patrickyeon/battery-characterizer/hw/instrumentationamp/outputs/instrument-amplifier.pdf

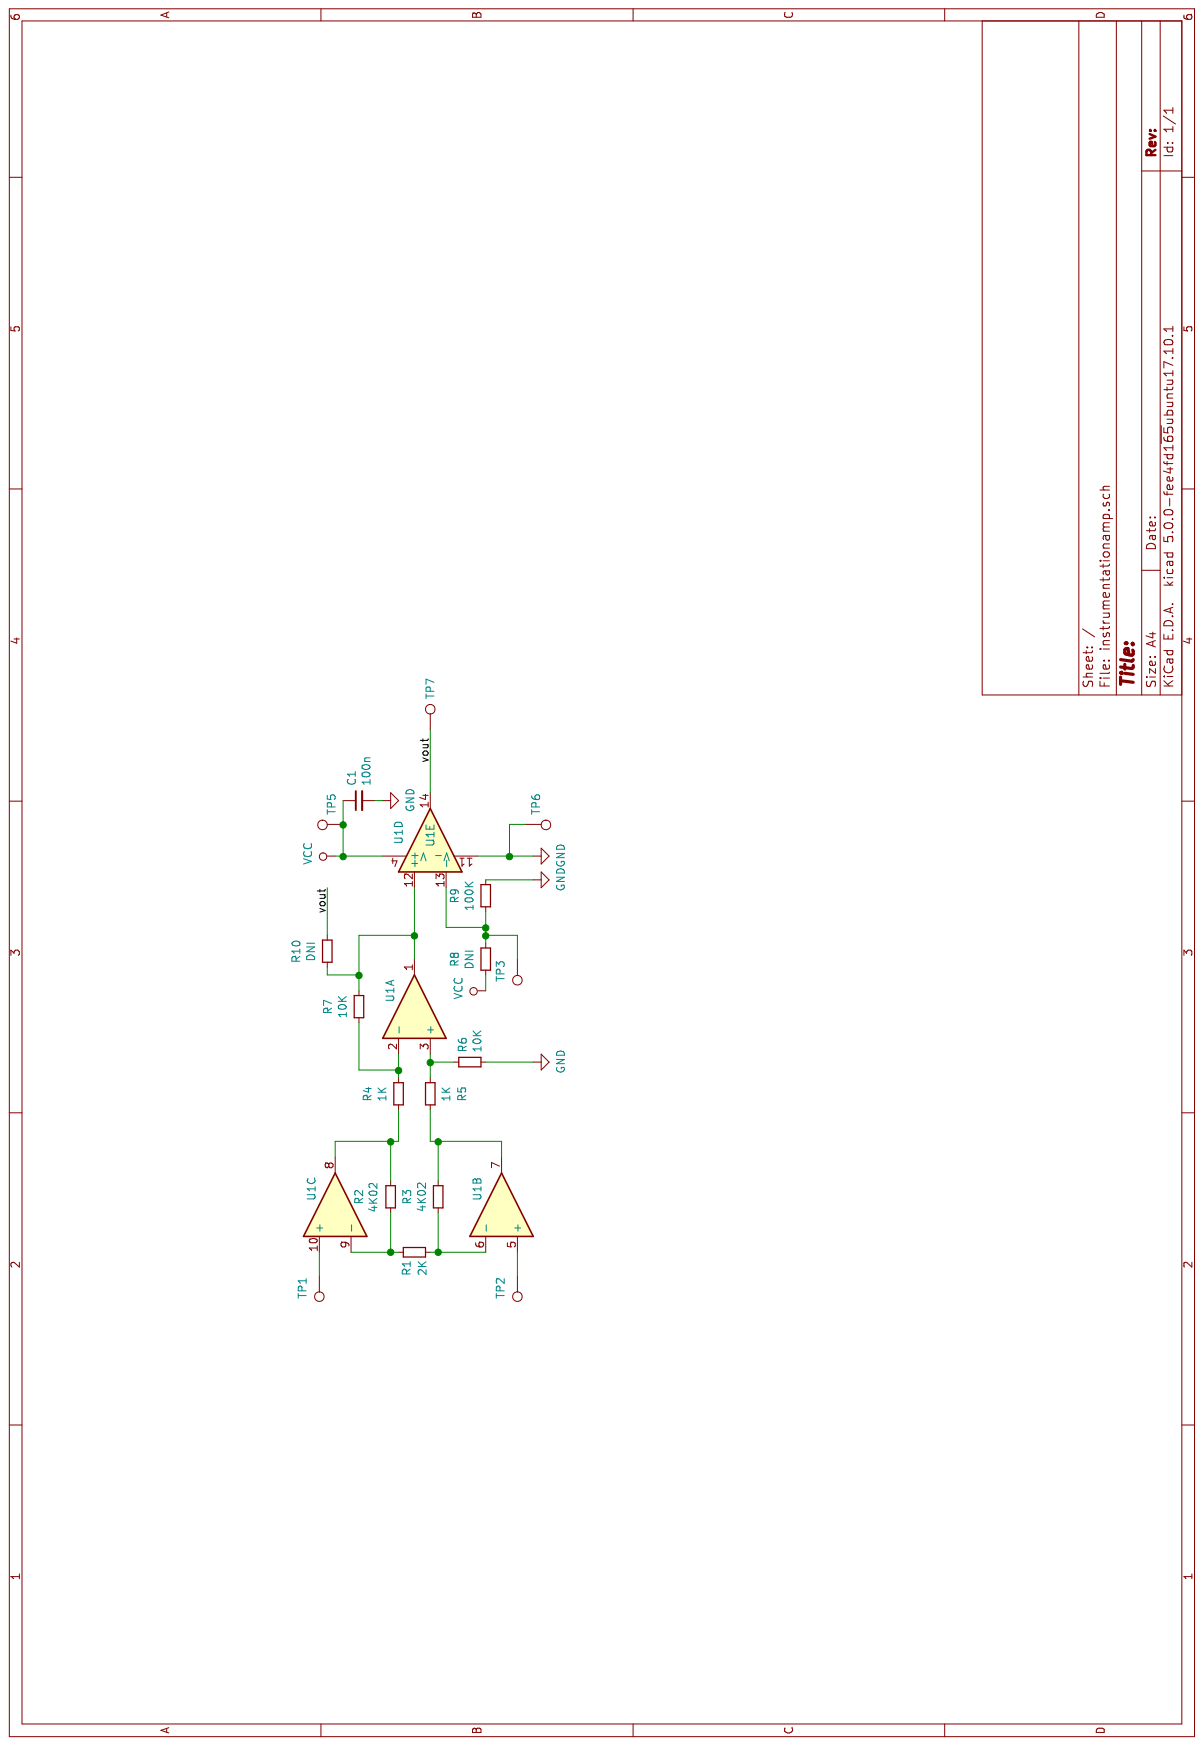
[picture p1: page 1]
