patrickyeon/battery-characterizer/docs/chrg_ilim.asc

C1: cap; 1µ
C2: cap; 100n
C3: cap; 10n
C4: cap; 1n
D1: schottky; MBRB2545CT
E1: e; 1000
M1: nmos; BSS123
M2: pmos; BSS84
R1: res; 4k
R2: res; 100meg
R3: res; 1k
R4: res; 1k
R5: res; 1k
R6: res; 10k
R7: res; 10k
R8: res; 0.01
R9: res; 3.3k
R10: res; 0.15
R11: res; 2k
R12: res; 1k
R13: res; 4k
R14: res; 4k
R15: res; 1k
R16: res; 3.3k
R17: res; 86.6k
R18: res; 14.3k
R19: res; 250k
R20: res; 250k
R21: res; 10k
U1: LTC6244
U2: LTC6244
U3: LTC6244
U4: LTC6244
V1: voltage; PULSE(0 3.3 0 1n 1n 0.001374m 0.01374m)
V2: voltage; 6
V3: voltage; 0.6
V4: voltage; 3.5
Named nets: 0, vpwm, vfilt, vcc, vhi, vctrl, vout, vlo, vsens
.tran 20m
VCC
MCU PWM output
