patrickyeon/battery-characterizer/docs/dchrg_ilim_modding.asc

C1: cap; 1µ
C2: cap; 10n
C3: cap; 10n
M1: nmos; BSS123
M2: nmos; BSS123
M3: nmos; PSMN6R130YLD
M4: nmos; BSS123
R1: res; 4k
R2: res; 100meg
R3: res; 1k
R4: res; 1k
R5: res; 1k
R6: res; 10k
R7: res; 10k
R8: res; 0.01
R9: res; 10k
R10: res; 0.15
R11: res; 2k
R12: res; 1k
R13: res; 4k
R14: res; 4k
R15: res; 10k
R16: res; 10k
R17: res; 10k
R18: res; 0
R19: res; 250k
R20: res; 250k
U1: LTC6244
U2: LTC6244
U3: LTC6244
U4: LTC6244
V1: voltage; PULSE(0 3.3 0 1n 1n 0.001374m 0.01375m)
V2: voltage; 6
V3: voltage; PULSE(3.3 0 15m 0.1u 0.1u 15m 40m)
V4: voltage; 4.5
Named nets: 0, vpwm, vfilt, vcc, vhi, vctrl, vout, vlo, en, vgate
.tran 20m
Enable/Disable logic
VCC
MCU PWM output
