patrickyeon/battery-characterizer/docs/direction_control.asc

D2: schottky; BAT54
D3: schottky; BAT54
D4: schottky; BAT54
D5: schottky; BAT54
I1: current; 0
I2: current; 0
M1: pmos; FDS4465
M2: pmos; FDS4465
M3: nmos; BSS123
M4: pmos; FDS4465
M5: pmos; FDS4465
M6: nmos; BSS123
M7: pmos; FDS4465
M8: pmos; FDS4465
M9: nmos; BSS123
M10: pmos; FDS4465
M11: pmos; FDS4465
M12: nmos; BSS123
R1: res; 3.3k
R2: res; 3.3k
R3: res; 3.3k
R4: res; 3.3k
R5: res; 0.15
R6: res; 3.3k
R7: res; 3.3k
R8: res; 3.3k
R9: res; 3.3k
R10: res; 0.15
R11: res; 0.01
R12: res; 0.01
V1: voltage; 6
V2: voltage; 3.3
V3: voltage; 0
V4: voltage; 3.5
V5: voltage; 3.5
Named nets: batt0, 0, dir, batt1, ndir, vchg, vcc, vdis
Charging section
Discharging
.op
