patrickyeon/battery-characterizer/docs/dchrg_ilim.asc

C1: cap; 1µ
C2: cap; 1µ
I1: current; SINE(0.4 0.4 20)
M1: nmos
R1: res; 4k
R2: res; 100k
R3: res; 2k
R4: res; 2k
R5: res; 1k
R6: res; 100k
R7: res; 100k
R8: res; 0.01
R9: res; 100k
R10: res; 2
R11: res; 100
R12: res; 200k
U1: LTC6244
U2: LTC6244
V1: voltage; PULSE(0 3.3 0 1n 1n 0.001374m 0.01375m)
V2: voltage; 6
V3: voltage; SINE(0.003 0.003 20)
Named nets: 0, vpwm, vfilt, vcc, vhi, vctrl, vout, vlo
.tran 80m
