patrickyeon/battery-characterizer/hw/instrumentationamp/instrumentationamp.kicad_pcb

## KiCad design hw/instrumentationamp/instrumentationamp.kicad_pcb (2018-10-24)

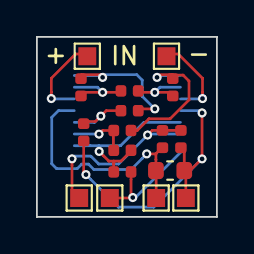
[picture p2: board instrumentationamp.kicad_pcb from above]

Board: 2 copper layers, 10.0 x 10.0 mm, 18 parts (1 on the bottom side), 13 nets.

Parts:
C1: 100n; C_0603_1608Metric
R1: 2K; R_0402_1005Metric
R2, R3: 4K02; R_0402_1005Metric
R4, R5: 1K; R_0402_1005Metric
R6, R7: 10K; R_0402_1005Metric
R8, R10: DNI; R_0402_1005Metric
R9: 100K; R_0402_1005Metric
TP1, TP2, TP3, TP5, TP6, TP7: Test_Point; TestPoint_Pad_1.0x1.0mm
U1: Opamp_Quad_Generic; TSSOP-14_4.4x5mm_P0.65mm

Connections:
/vout: R10.1, TP7.1, U1.14
GND: C1.2, R6.2, R9.1, TP6.1, U1.11
unnamed: R1.1, R2.1, U1.9
unnamed: R1.2, R3.2, U1.6
unnamed: R2.2, R4.2, U1.8
unnamed: R3.1, R5.2, U1.7
unnamed: R4.1, R7.2, U1.2
unnamed: R5.1, R6.1, U1.3
unnamed: R8.1, R9.2, TP3.1, U1.13
unnamed: R7.1, R10.2, U1.1, U1.12
unnamed: TP1.1, U1.10
unnamed: TP2.1, U1.5
VCC: C1.1, R8.2, TP5.1, U1.4
