patrickyeon/battery-characterizer/hw/characterizer/characterizer.kicad_pcb

## KiCad design hw/characterizer/characterizer.kicad_pcb (2018-10-16)

Schematic: characterizer.sch

Parts:
C1: 1u; C_0603_1608Metric
C2: 470p; C_0603_1608Metric
C3: 2u2; C_0603_1608Metric
J1: 1988820; TERM_4_5mm; Digikey PN 277-1766-ND
R1: 0R; R_0603_1608Metric
R2: DNI; R_0603_1608Metric
R3, R4, R5: 10k; R_0603_1608Metric
U1: MIC5205-3.3; SOT-23-5; Digikey PN 576-1259-1-ND

Connections:
+3V3: C3.1, R5.1, U1.5 (OUT); also elsewhere on the board
+5V: R2.1; also elsewhere on the board
+6V: J1.1, J1.2, R1.1; also elsewhere on the board
/pairA/ADDR: R4.1; also elsewhere on the board
/pairB/ADDR: R5.2; also elsewhere on the board
GND: C1.2, C2.2, C3.2, J1.3, J1.4, R4.2, U1.2 (GND); also elsewhere on the board
unnamed: C1.1, R1.2, R2.2, R3.1, U1.1 (IN)
unnamed: C2.1, U1.4 (BP)
unnamed: R3.2, U1.3 (EN)

Schematic: control.sch

Parts:
C4: 4n7; C_0603_1608Metric
C5, C7, C9, C10, C11, C12, C13, C14: 100n; C_0603_1608Metric
C6, C8: 18p; C_0603_1608Metric
J2: Conn_02x05_Odd_Even; CONN_JTAG_10; Digikey PN 1175-1629-ND
J3: 10118194-0001LF; USB-microB-AMPH; Digikey PN 609-4618-1-ND
R6: 1M; R_0603_1608Metric
R7: DNI; R_0603_1608Metric
R8, R13, R14, R15, R16, R19, R20, R21, R22: 10k; R_0603_1608Metric
R9: 100k; R_0603_1608Metric
R10: 0; R_0603_1608Metric
R11, R12: 3k3; R_0603_1608Metric
R17, R18, R23, R24: 4k02; R_0603_1608Metric
U2: STM32F042K6T6; LQFP-32_7x7mm_P0.8mm; Digikey PN 497-14647-ND
U3: 74LVC2G04GW,125; SOT-363_SC-70-6; Digikey PN 1727-4032-1-ND
Y1: ABLS-8.000MHZ-B4-T; Crystal_SMD_HC49-SD; Digikey PN 535-10212-1-ND

Connections:
+3V3: C5.1, C7.1, C9.1, C10.1, J2.1, R7.1, R11.2, R12.2, U2.1, U2.5, U2.17, U3.5; also elsewhere on the board
+5V: R10.1; also elsewhere on the board
/SCL: R12.1, U2.19; also elsewhere on the board
/SDA: R11.1, U2.20; also elsewhere on the board
/mcu/CC_A: U2.6; also elsewhere on the board
/mcu/CC_B: U2.7; also elsewhere on the board
/mcu/CEN_A: U2.29; also elsewhere on the board
/mcu/CEN_B: U2.25; also elsewhere on the board
/mcu/DC_A: U2.8; also elsewhere on the board
/mcu/DC_B: U2.9; also elsewhere on the board
/mcu/ICHG_A: C14.1, R24.1; also elsewhere on the board
/mcu/ICHG_B: C12.1, R18.1; also elsewhere on the board
/mcu/IDCHG_A: C13.1, R23.1; also elsewhere on the board
/mcu/IDCHG_B: C11.1, R17.1; also elsewhere on the board
/mcu/VBAT0: R15.1; also elsewhere on the board
/mcu/VBAT1: R21.1; also elsewhere on the board
/mcu/VBAT2: R16.1; also elsewhere on the board
/mcu/VBAT3: R22.1; also elsewhere on the board
/pairA/DCHARGE: U2.30; also elsewhere on the board
/pairA/DIR: U2.18, U3.3; also elsewhere on the board
/pairA/nDIR: U3.4; also elsewhere on the board
/pairB/DCHARGE: R7.2, R8.1, U2.31; also elsewhere on the board
/pairB/DIR: U2.26, U3.1; also elsewhere on the board
/pairB/nDIR: U3.6; also elsewhere on the board
GND: C4.2, C5.2, C6.2, C7.2, C8.2, C9.2, C10.2, C11.2, C12.2, C13.2, C14.2, J2.3, J2.5, J2.9, J3.5, R6.1, R8.2, R9.1, R13.2, R14.2, R19.2, R20.2, U2.16, U2.32, U3.2; also elsewhere on the board
unnamed: C4.1, J3.6, J3.7, J3.8, J3.9, R6.2
unnamed: C6.1, U2.2, Y1.1
unnamed: C8.1, U2.3, Y1.2
unnamed: J2.2, U2.23
unnamed: J2.4, U2.24
unnamed: J2.10, U2.4
unnamed: J3.1, R10.2
unnamed: J3.2, U2.21
unnamed: J3.3, U2.22
unnamed: J3.4, R9.2
unnamed: R13.1, R15.2, U2.11
unnamed: R14.1, R16.2, U2.13
unnamed: R17.2, U2.15
unnamed: R18.2, U2.28
unnamed: R19.1, R21.2, U2.10
unnamed: R20.1, R22.2, U2.12
unnamed: R23.2, U2.14
unnamed: R24.2, U2.27

Schematic: pair.sch

Parts:
BT1, BT2: Battery_Cell; 18650-keyelco
C15, C16: 100n; C_0603_1608Metric
F1, F2: MF-USML700-2; R_1210_3225Metric; Digikey PN MF-USML700-2CT-ND
J4, J5, J6, J7: 36-54-ND; BATTERY_CLIP_36-54; Digikey PN 36-54-ND
R25, R26, R27, R28: 10k; R_0603_1608Metric
U4, U5: AT30TS74; MSOP-8_3x3mm_P0.65mm; Digikey PN 1611-AT30TS74-XM8M-B-ND

Connections:
+3V3: C15.1, C16.1, R26.1, U4.8, U5.8; also elsewhere on the board
/SCL: U4.2, U5.2; also elsewhere on the board
/SDA: U4.1, U5.1; also elsewhere on the board
/mcu/VBAT2: J4.1, J4.2, J4.3; also elsewhere on the board
/mcu/VBAT3: J6.1, J6.2, J6.3; also elsewhere on the board
/pairB/ADDR: U4.5, U5.5; also elsewhere on the board
GND: C15.2, C16.2, F1.2, F2.2, R25.2, R27.2, R28.2, U4.4, U5.4; also elsewhere on the board
unnamed: F1.1, J5.1, J5.2, J5.3
unnamed: F2.1, J7.1, J7.2, J7.3
unnamed: R25.1, U4.7
unnamed: R26.2, U5.7
unnamed: R27.1, U4.6
unnamed: R28.1, U5.6

Parts of its further copies:
BT3, BT4: Battery_Cell; 18650-keyelco
C32, C33: 100n; C_0603_1608Metric
F3, F4: MF-USML700-2; R_1210_3225Metric; Digikey PN MF-USML700-2CT-ND
J8, J9, J10, J11: 36-54-ND; BATTERY_CLIP_36-54; Digikey PN 36-54-ND
R62, R63, R64, R65: 10k; R_0603_1608Metric
U9, U10: AT30TS74; MSOP-8_3x3mm_P0.65mm; Digikey PN 1611-AT30TS74-XM8M-B-ND

Connections of its further copies:
+3V3: C32.1, C33.1, R63.1, U9.8, U10.8; also elsewhere on the board
/SCL: U9.2, U10.2; also elsewhere on the board
/SDA: U9.1, U10.1; also elsewhere on the board
/mcu/VBAT0: J8.1, J8.2, J8.3; also elsewhere on the board
/mcu/VBAT1: J10.1, J10.2, J10.3; also elsewhere on the board
/pairA/ADDR: U9.5, U10.5; also elsewhere on the board
GND: C32.2, C33.2, F3.2, F4.2, R62.2, R64.2, R65.2, U9.4, U10.4; also elsewhere on the board
unnamed: F3.1, J9.1, J9.2, J9.3
unnamed: F4.1, J11.1, J11.2, J11.3
unnamed: R62.1, U9.7
unnamed: R63.2, U10.7
unnamed: R64.1, U9.6
unnamed: R65.1, U10.6

Schematic: load.sch

Parts:
C17, C19: DNI; C_0603_1608Metric
C18: 100n; C_0603_1608Metric
Q1, Q2, Q6, Q8: BSS123; SOT-23; Digikey PN BSS123W-FDICT-ND
Q3, Q4, Q29, Q30: FDMA008P20LZ; MICROFET_2x2; Digikey PN FDMA008P20LZOSCT-ND
Q5: PSMN7R0-30MLC,115; LFPAK33; Digikey PN 1727-7144-1-ND
Q7: BSS84; SOT-23; Digikey PN BSS84W-FDICT-ND
R29, R30, R32, R34, R36: 3k3; R_0603_1608Metric
R31, R35: 20k; R_0603_1608Metric
R33: 0r01; R_2010_5025Metric; Digikey PN CSRN2010FK10L0CT-ND
R37: 2k; R_0603_1608Metric
R38, R41: 1k; R_0603_1608Metric
R39: 0; R_0603_1608Metric
R40, R42, R43: 10k; R_0603_1608Metric
TP1, TP2, TP3: Test_Point; PinHeader_1x01_P2.54mm_Vertical
U6: TLV272CS-13; MSOP-8_3x3mm_P0.65mm; Digikey PN TLV272IM8-13DICT-ND

Connections:
+6V: C18.2, R29.2, R30.2, R37.2, U6.8; also elsewhere on the board
/mcu/DC_B: R35.1, U6.1, U6.5; also elsewhere on the board
/mcu/IDCHG_B: R37.1, R38.2, U6.6; also elsewhere on the board
/mcu/VBAT2: Q29.S, Q29.S2; also elsewhere on the board
/mcu/VBAT3: Q30.S, Q30.S2; also elsewhere on the board
/pairB/DCHARGE: Q8.1, R43.1; also elsewhere on the board
/pairB/DIR: Q2.1; also elsewhere on the board
/pairB/nDIR: Q1.1; also elsewhere on the board
GND: C18.1, C19.1, Q1.2, Q2.2, Q5.1, Q5.2, Q5.3, Q6.2, Q8.2, R31.2, R38.1, R40.2, R43.2, U6.4; also elsewhere on the board
unnamed: C17.1, Q5.4, R36.2, R39.2
unnamed: C17.2, Q5.5, R33.1, R34.1, R36.1
unnamed: C19.2, Q7.2, R41.1, R42.1
unnamed: Q1.3, Q3.G, Q29.G, R29.1
unnamed: Q2.3, Q4.G, Q30.G, R30.1
unnamed: Q3.S, Q3.S2, Q4.S, Q4.S2, R32.1, R33.2
unnamed: Q6.1, Q7.3, R40.1
unnamed: Q6.3, R39.1
unnamed: Q7.1, Q8.3, R42.2
unnamed: Q3.D, Q29.D
unnamed: Q4.D, Q30.D
unnamed: R31.1, R32.2, U6.3
unnamed: R34.2, R35.2, U6.2
unnamed: R41.2, U6.7

Parts of its further copies:
C34, C36: DNI; C_0603_1608Metric
C35: 100n; C_0603_1608Metric
Q15, Q16, Q20, Q22: BSS123; SOT-23; Digikey PN BSS123W-FDICT-ND
Q17, Q18, Q33, Q34: FDMA008P20LZ; MICROFET_2x2; Digikey PN FDMA008P20LZOSCT-ND
Q19: PSMN7R0-30MLC,115; LFPAK33; Digikey PN 1727-7144-1-ND
Q21: BSS84; SOT-23; Digikey PN BSS84W-FDICT-ND
R66, R67, R69, R71, R73: 3k3; R_0603_1608Metric
R68, R72: 20k; R_0603_1608Metric
R70: 0r01; R_2010_5025Metric; Digikey PN CSRN2010FK10L0CT-ND
R74: 2k; R_0603_1608Metric
R75, R78: 1k; R_0603_1608Metric
R76: 0; R_0603_1608Metric
R77, R79, R80: 10k; R_0603_1608Metric
TP7, TP8, TP9: Test_Point; PinHeader_1x01_P2.54mm_Vertical
U11: TLV272CS-13; MSOP-8_3x3mm_P0.65mm; Digikey PN TLV272IM8-13DICT-ND

Connections of its further copies:
+6V: C35.2, R66.2, R67.2, R74.2, U11.8; also elsewhere on the board
/mcu/DC_A: R72.1, U11.1, U11.5; also elsewhere on the board
/mcu/IDCHG_A: R74.1, R75.2, U11.6; also elsewhere on the board
/mcu/VBAT0: Q33.S, Q33.S2; also elsewhere on the board
/mcu/VBAT1: Q34.S, Q34.S2; also elsewhere on the board
/pairA/DCHARGE: Q22.1, R80.1; also elsewhere on the board
/pairA/DIR: Q16.1; also elsewhere on the board
/pairA/nDIR: Q15.1; also elsewhere on the board
GND: C35.1, C36.1, Q15.2, Q16.2, Q19.1, Q19.2, Q19.3, Q20.2, Q22.2, R68.2, R75.1, R77.2, R80.2, U11.4; also elsewhere on the board
unnamed: C34.1, Q19.4, R73.2, R76.2
unnamed: C34.2, Q19.5, R70.1, R71.1, R73.1
unnamed: C36.2, Q21.2, R78.1, R79.1
unnamed: Q15.3, Q17.G, Q33.G, R66.1
unnamed: Q16.3, Q18.G, Q34.G, R67.1
unnamed: Q17.D, Q33.D
unnamed: Q17.S, Q17.S2, Q18.S, Q18.S2, R69.1, R70.2
unnamed: Q18.D, Q34.D
unnamed: Q20.1, Q21.3, R77.1
unnamed: Q20.3, R76.1
unnamed: Q21.1, Q22.3, R79.2
unnamed: R68.1, R69.2, U11.3
unnamed: R71.2, R72.2, U11.2
unnamed: R78.2, U11.7

Notes on the sheet:
30W here

Schematic: charger.sch

Parts:
C20: 10n; C_0603_1608Metric
C21, C22, C23, C28: 10u; C_1206_3216Metric; Digikey PN 311-1376-1-ND
C24: 63p4; C_0603_1608Metric
C25, C27, C30: 100n; C_0603_1608Metric
C26: 1n91; C_0603_1608Metric
C29, C31: DNI; C_0603_1608Metric
L1: 2.2uH; IND-10.4x10.4; Digikey PN 495-1799-1-ND
Q9, Q10, Q14: BSS123; SOT-23; Digikey PN BSS123W-FDICT-ND
Q11, Q12, Q31, Q32: FDMA008P20LZ; MICROFET_2x2; Digikey PN FDMA008P20LZOSCT-ND
Q13: BSS84; SOT-23; Digikey PN BSS84W-FDICT-ND
R44, R46, R47, R50, R52, R56, R60: 3k3; R_0603_1608Metric
R45: 78k7; R_0603_1608Metric
R48: 2k61; R_0603_1608Metric
R49, R55: 20k; R_0603_1608Metric
R51: 0r01; R_2010_5025Metric; Digikey PN CSRN2010FK10L0CT-ND
R53: 86k6; R_0603_1608Metric
R54: 14k3; R_0603_1608Metric
R57: 2k; R_0603_1608Metric
R58: 1k; R_0603_1608Metric
R59, R61: 0; R_0603_1608Metric
TP4, TP5, TP6: Test_Point; PinHeader_1x01_P2.54mm_Vertical
U7: TPS54719; WQFN-16-1EP_3x3mm_P0.5mm_EP1.75x1.75mm; Digikey PN 296-36812-1-ND
U8: TLV272CS-13; MSOP-8_3x3mm_P0.65mm; Digikey PN TLV272IM8-13DICT-ND

Connections:
+6V: C21.1, C22.1, C23.1, C25.2, C30.2, R44.1, R46.1, R47.2, R57.2, U7.1, U7.2, U7.16, U8.8; also elsewhere on the board
/mcu/CC_B: R55.1, U8.1, U8.5; also elsewhere on the board
/mcu/CEN_B: U7.15; also elsewhere on the board
/mcu/ICHG_B: R57.1, R58.2, U8.6; also elsewhere on the board
/mcu/VBAT2: Q31.S, Q31.S2; also elsewhere on the board
/mcu/VBAT3: Q32.S, Q32.S2; also elsewhere on the board
/pairB/DIR: Q9.1; also elsewhere on the board
/pairB/nDIR: Q10.1; also elsewhere on the board
/pairB/sheet5BBBF842/Vbatt: C29.1, Q11.S, Q11.S2, Q12.S, Q12.S2, Q13.2, R51.1, R52.1, R53.1, R56.1
/pairB/sheet5BBBF842/Vsens: Q13.3, R53.2, R54.1, U7.6
GND: C20.2, C21.2, C22.2, C23.2, C24.2, C25.1, C26.2, C28.2, C30.1, C31.2, Q9.2, Q10.2, Q14.2, R45.2, R49.2, R54.2, R58.1, R60.2, U7.3, U7.4, U7.5, U7.17, U8.4; also elsewhere on the board
unnamed: C20.1, U7.9
unnamed: C24.1, R48.1, U7.7
unnamed: C26.1, R48.2
unnamed: C27.1, L1.1, U7.10, U7.11, U7.12
unnamed: C27.2, U7.13
unnamed: C28.1, L1.2, R50.1, R51.2
unnamed: C29.2, Q13.1, R56.2, R59.2
unnamed: C31.1, Q14.1, R60.1, R61.2
unnamed: Q10.3, Q12.G, Q32.G, R47.1
unnamed: Q11.D, Q31.D
unnamed: Q9.3, Q11.G, Q31.G, R46.2
unnamed: Q12.D, Q32.D
unnamed: Q14.3, R59.1
unnamed: R44.2, U7.14
unnamed: R45.1, U7.8
unnamed: R49.1, R50.2, U8.3
unnamed: R52.2, R55.2, U8.2
unnamed: R61.1, U8.7

Parts of its further copies:
C37: 10n; C_0603_1608Metric
C38, C39, C40, C45: 10u; C_1206_3216Metric; Digikey PN 311-1376-1-ND
C41: 63p4; C_0603_1608Metric
C42, C44, C47: 100n; C_0603_1608Metric
C43: 1n91; C_0603_1608Metric
C46, C48: DNI; C_0603_1608Metric
L2: 2.2uH; IND-10.4x10.4; Digikey PN 495-1799-1-ND
Q23, Q24, Q28: BSS123; SOT-23; Digikey PN BSS123W-FDICT-ND
Q25, Q26, Q35, Q36: FDMA008P20LZ; MICROFET_2x2; Digikey PN FDMA008P20LZOSCT-ND
Q27: BSS84; SOT-23; Digikey PN BSS84W-FDICT-ND
R81, R83, R84, R87, R89, R93, R97: 3k3; R_0603_1608Metric
R82: 78k7; R_0603_1608Metric
R85: 2k61; R_0603_1608Metric
R86, R92: 20k; R_0603_1608Metric
R88: 0r01; R_2010_5025Metric; Digikey PN CSRN2010FK10L0CT-ND
R90: 86k6; R_0603_1608Metric
R91: 14k3; R_0603_1608Metric
R94: 2k; R_0603_1608Metric
R95: 1k; R_0603_1608Metric
R96, R98: 0; R_0603_1608Metric
TP10, TP11, TP12: Test_Point; PinHeader_1x01_P2.54mm_Vertical
U12: TPS54719; WQFN-16-1EP_3x3mm_P0.5mm_EP1.75x1.75mm; Digikey PN 296-36812-1-ND
U13: TLV272CS-13; MSOP-8_3x3mm_P0.65mm; Digikey PN TLV272IM8-13DICT-ND

Connections of its further copies:
+6V: C38.1, C39.1, C40.1, C42.2, C47.2, R81.1, R83.1, R84.2, R94.2, U12.1, U12.2, U12.16, U13.8; also elsewhere on the board
/mcu/CC_A: R92.1, U13.1, U13.5; also elsewhere on the board
/mcu/CEN_A: U12.15; also elsewhere on the board
/mcu/ICHG_A: R94.1, R95.2, U13.6; also elsewhere on the board
/mcu/VBAT0: Q35.S, Q35.S2; also elsewhere on the board
/mcu/VBAT1: Q36.S, Q36.S2; also elsewhere on the board
/pairA/DIR: Q23.1; also elsewhere on the board
/pairA/nDIR: Q24.1; also elsewhere on the board
/pairA/sheet5BBBF842/Vbatt: C46.1, Q25.S, Q25.S2, Q26.S, Q26.S2, Q27.2, R88.1, R89.1, R90.1, R93.1
/pairA/sheet5BBBF842/Vsens: Q27.3, R90.2, R91.1, U12.6
GND: C37.2, C38.2, C39.2, C40.2, C41.2, C42.1, C43.2, C45.2, C47.1, C48.2, Q23.2, Q24.2, Q28.2, R82.2, R86.2, R91.2, R95.1, R97.2, U12.3, U12.4, U12.5, U12.17, U13.4; also elsewhere on the board
unnamed: C37.1, U12.9
unnamed: C41.1, R85.1, U12.7
unnamed: C43.1, R85.2
unnamed: C44.1, L2.1, U12.10, U12.11, U12.12
unnamed: C44.2, U12.13
unnamed: C45.1, L2.2, R87.1, R88.2
unnamed: C46.2, Q27.1, R93.2, R96.2
unnamed: C48.1, Q28.1, R97.1, R98.2
unnamed: Q23.3, Q25.G, Q35.G, R83.2
unnamed: Q24.3, Q26.G, Q36.G, R84.1
unnamed: Q25.D, Q35.D
unnamed: Q26.D, Q36.D
unnamed: Q28.3, R96.1
unnamed: R81.2, U12.14
unnamed: R82.1, U12.8
unnamed: R86.1, R87.2, U13.3
unnamed: R89.2, R92.2, U13.2
unnamed: R98.1, U13.7

Notes on the sheet:
internally pulled up
500kHz
4.125u after DC bias (tool suggested CC0603MRX5R5BB106)
10u total, after DC bias effect

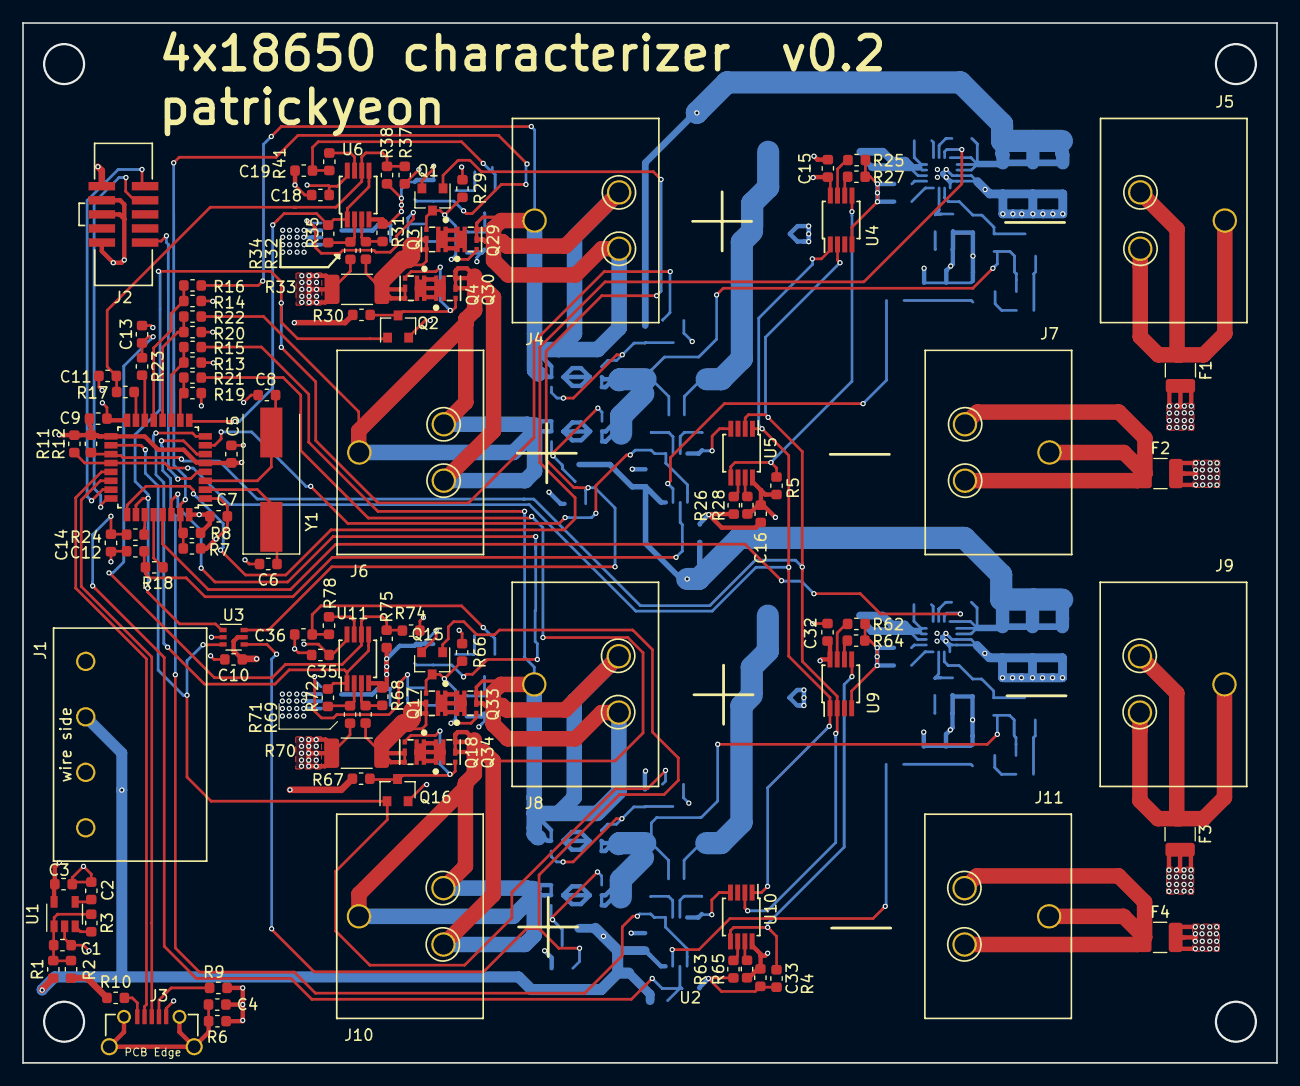
[picture p3: board characterizer.kicad_pcb from above]

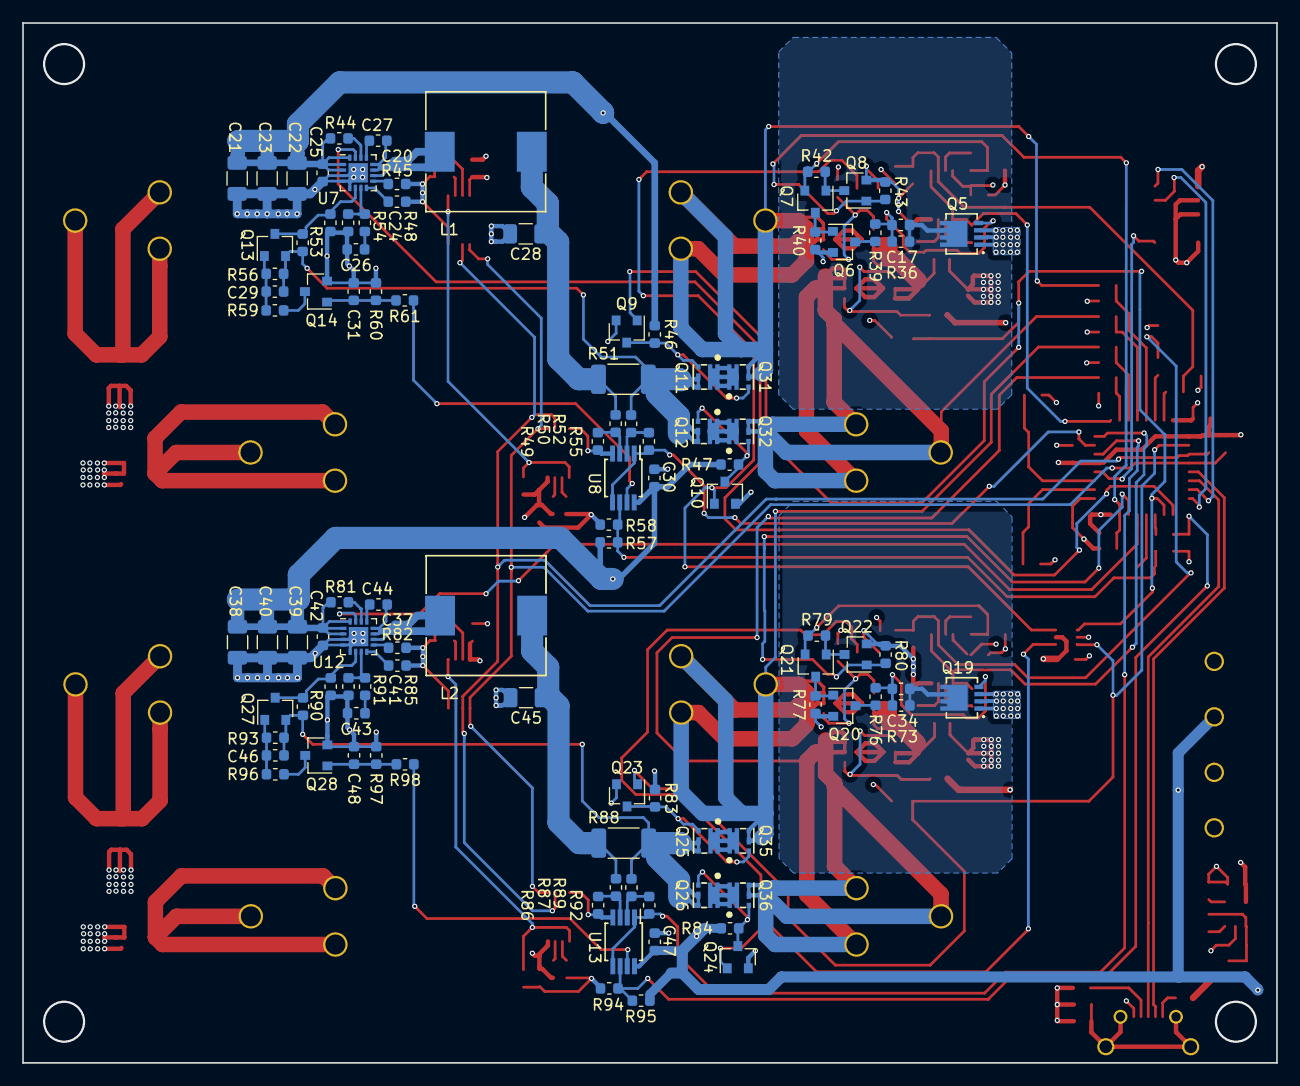
[picture p4: board characterizer.kicad_pcb from below]

Board: 4 copper layers, 113.0 x 93.7 mm, 217 parts (102 on the bottom side), 129 nets.
