patrickyeon/battery-characterizer/(commit log)

2018-09-19 initial schematic, start layout
    [characterizer.kicad_pcb, characterizer.sch, charger.sch, control.sch, load.sch, pair.sch]
2018-09-24 layout functionally complete
    [characterizer.kicad_pcb, charger.sch, control.sch, load.sch, pair.sch]
2018-09-25 layout as-ordered
    [characterizer.kicad_pcb]
2018-09-27 well, start of charge 'director', and required testing framework
2018-09-27 direction switching implemented
2018-09-28 basic cell voltage checking before starting charge/discharge
2018-09-28 updated makefile to build drivers too
2018-09-28 small layout fix
    [characterizer.kicad_pcb]
2018-09-28 WAG at an ADC driver
2018-09-28 very simple driver for AT30TS74
2018-09-28 director_checkup for an in-progress charge/discharge cycle
2018-09-29 updating schematic with digikey pns
    [characterizer_bom_.csv, charger.sch, control.sch, load.sch, pair.sch]
2018-10-04 now we can write across many pages, error on overflow
    [logger.c, logger.h, test_logger.c]
2018-10-04 stricter compiler settings, and fixing them
    [director.c, fake_stm_adc.c, logger.c, test_logger.c]
2018-10-05 for the easiest case, we can now dequeue from log
2018-10-09 USB driver brought in, start of command handler
2018-10-16 small board fixes
    [characterizer.kicad_pcb, charger.sch, load.sch, pair.sch]
2018-10-17 i2c temp sensors confirmed working
2018-10-17 ADC works, needs to be prettier
2018-10-23 a PWM that works at least
2018-10-23 log current, voltage not as adc codes
2018-10-23 proper use of PWM outputs for current setting
2018-10-24 made a tiny instrumentation amplifier board to cover for a mistake on the design
    [instrumentationamp-B.Cu.gbr, instrumentationamp-B.Mask.gbr, instrumentationamp-B.SilkS.gbr, instrumentationamp-Edge.Cuts.gbr, instrumentationamp-F.Cu.gbr, instrumentationamp-F.Mask.gbr, instrumentationamp-F.SilkS.gbr, instrumentationamp-PTH.drl]
2018-10-31 fix pwm output mapping
    [gpio.c]
2018-10-31 part number for instrumentation amp
    [instrumentationamp.sch]
2018-10-31 discharge current control with pwm spice sim
2018-11-08 two timers for two indep. tick/tock
2018-11-08 bugfix for reading ADC
    [comms.py]
2018-11-09 small re-org on comms.py, now claim exclusive use of serial device
2018-11-11 just a couple more things for standard build
2018-11-12 i2c timeouts and nacks handled. not great, but not horrible
2018-11-12 updating tests to track code changes
2018-11-13 adding a watchdog timer
2018-11-25 reworking i2c timeouts so that it doesn't bog down when nothing is on the bus
    [at30ts74.c, commands.c, director.c, director.h, i2c.c, main.c, temperature.c, temperature.h]
2018-11-25 I2C working and at 1MHz
2018-11-25 whoops, clean up i2c errors
    [i2c.c, i2c.h]
2018-11-26 writeup from i2c adventures
2018-12-07 ADC has averaging, internal vref, and temperature
